kasai-haruki/fpga-digital-clock/docs/videos/境界線テスト_2000_12_31_23_59_59.gif

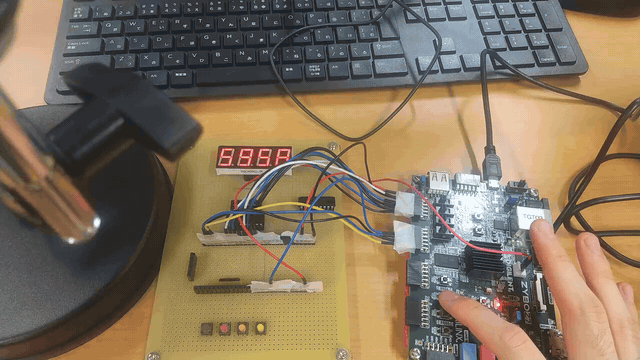
docs/videos/境界線テスト_2000_12_31_23_59_59.gif
