kasai-haruki/fpga-digital-clock/docs/videos/境界線テスト_2001_2_28_23_59_59.gif

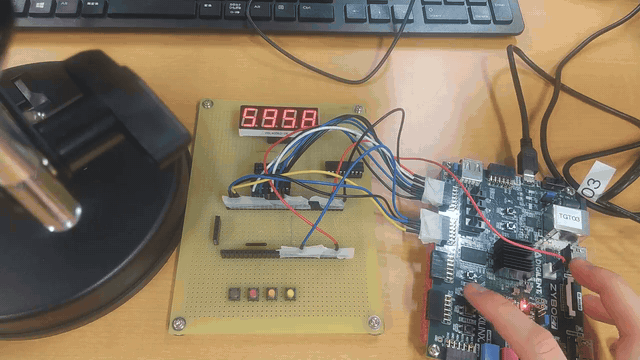
docs/videos/境界線テスト_2001_2_28_23_59_59.gif
