kasai-haruki/fpga-digital-clock/constraints/CLOCK_ALL.xdc

#Clock signal
set_property -dict { PACKAGE_PIN K17   IOSTANDARD LVCMOS33 } [get_ports { CLK }]; #IO_L12P_T1_MRCC_35 Sch=sysclk
create_clock -add -name sys_clk_pin -period 8.00 -waveform {0 4} [get_ports { CLK }];

#Buttons
set_property -dict {PACKAGE_PIN K18 IOSTANDARD LVCMOS33} [get_ports RESET]
set_property -dict {PACKAGE_PIN P16 IOSTANDARD LVCMOS33} [get_ports btn_switch]
set_property -dict {PACKAGE_PIN K19 IOSTANDARD LVCMOS33} [get_ports btn_display]; #IO_L10P_T1_AD11P_35 Sch=btn[2]
set_property -dict { PACKAGE_PIN Y16   IOSTANDARD LVCMOS33 } [get_ports btn_inc]; #IO_L7P_T1_34 Sch=btn[3]

#Pmod Header JE
set_property -dict {PACKAGE_PIN V12 IOSTANDARD LVCMOS33} [get_ports {LED[7]}]
set_property -dict {PACKAGE_PIN W16 IOSTANDARD LVCMOS33} [get_ports {LED[6]}]
set_property -dict {PACKAGE_PIN J15 IOSTANDARD LVCMOS33} [get_ports {LED[5]}]
set_property -dict {PACKAGE_PIN H15 IOSTANDARD LVCMOS33} [get_ports {LED[4]}]
set_property -dict {PACKAGE_PIN V13 IOSTANDARD LVCMOS33} [get_ports {LED[3]}]
set_property -dict {PACKAGE_PIN U17 IOSTANDARD LVCMOS33} [get_ports {LED[2]}]
set_property -dict {PACKAGE_PIN T17 IOSTANDARD LVCMOS33} [get_ports {LED[1]}]
set_property -dict {PACKAGE_PIN Y17 IOSTANDARD LVCMOS33} [get_ports {LED[0]}]

#Pmod Header JD                                                                                                                  
set_property -dict { PACKAGE_PIN T14   IOSTANDARD LVCMOS33     } [get_ports { SA[0] }]; #IO_L5P_T0_34 Sch=jd_p[1]                  
set_property -dict { PACKAGE_PIN T15   IOSTANDARD LVCMOS33     } [get_ports { SA[1] }]; #IO_L5N_T0_34 Sch=jd_n[1]				 
set_property -dict { PACKAGE_PIN P14   IOSTANDARD LVCMOS33     } [get_ports { SA[2] }]; #IO_L6P_T0_34 Sch=jd_p[2]                  
set_property -dict { PACKAGE_PIN R14   IOSTANDARD LVCMOS33     } [get_ports { SA[3] }]; #IO_L6N_T0_VREF_34 Sch=jd_n[2]             
#set_property -dict { PACKAGE_PIN U14   IOSTANDARD LVCMOS33     } [get_ports { jd[4] }]; #IO_L11P_T1_SRCC_34 Sch=jd_p[3]            
#set_property -dict { PACKAGE_PIN U15   IOSTANDARD LVCMOS33     } [get_ports { jd[5] }]; #IO_L11N_T1_SRCC_34 Sch=jd_n[3]            
#set_property -dict { PACKAGE_PIN V17   IOSTANDARD LVCMOS33     } [get_ports { jd[6] }]; #IO_L21P_T3_DQS_34 Sch=jd_p[4]             
#set_property -dict { PACKAGE_PIN V18   IOSTANDARD LVCMOS33     } [get_ports { jd[7] }]; #IO_L21N_T3_DQS_34 Sch=jd_n[4]                 
